maximizeschneider/Clawdmeter/enclosure/retro_tv/preview_right.png

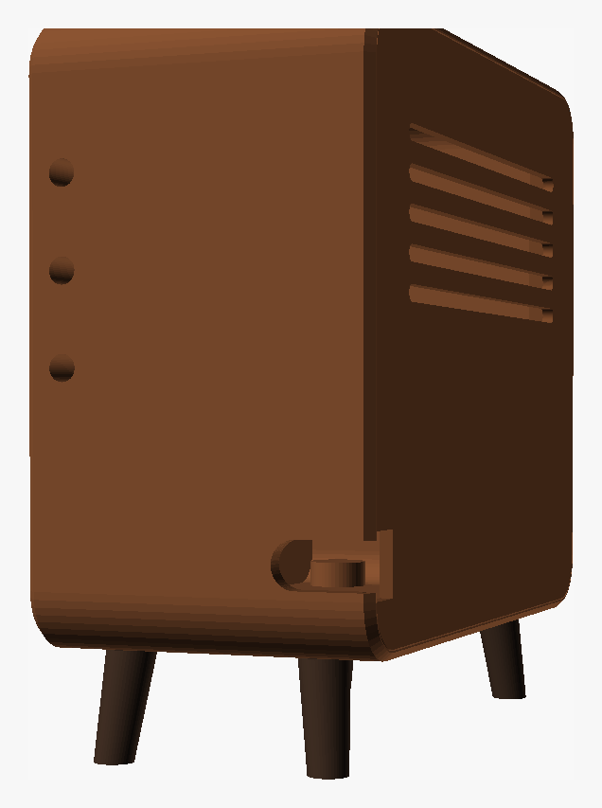
enclosure/retro_tv/preview_right.png
