maximizeschneider/Clawdmeter/enclosure/retro_tv/stl/0_fit_test.stl

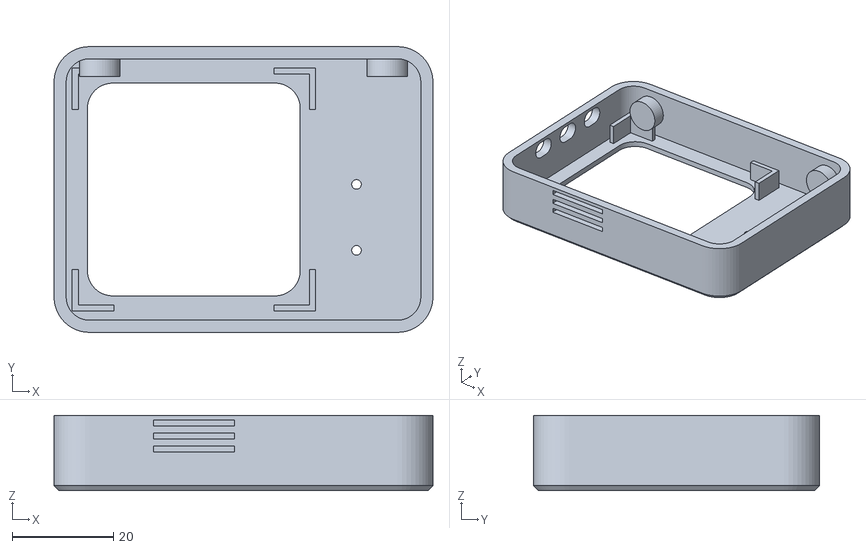
[picture p6: CAD file, 2026-10-17]
enclosure/retro_tv/stl/0_fit_test.stl
74.8 x 56.4 x 14.9
