maximizeschneider/Clawdmeter/enclosure/retro_tv/stl/1_classic/4_grey.stl

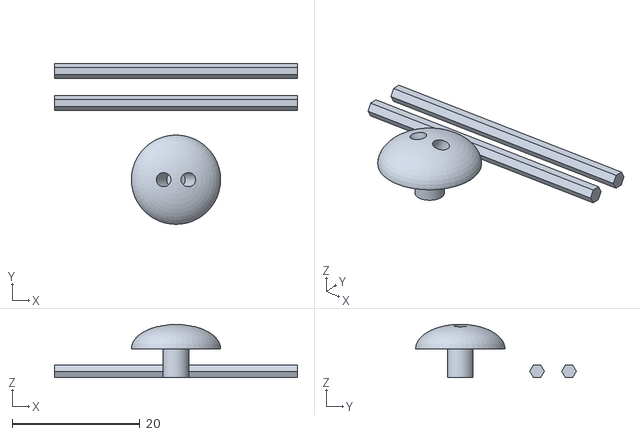
[picture p7: CAD file, 2026-10-17]
enclosure/retro_tv/stl/1_classic/4_grey.stl
38.0 x 25.1 x 8.34
