maximizeschneider/Clawdmeter/enclosure/retro_tv/stl/2_black_grey/2_light_grey.stl

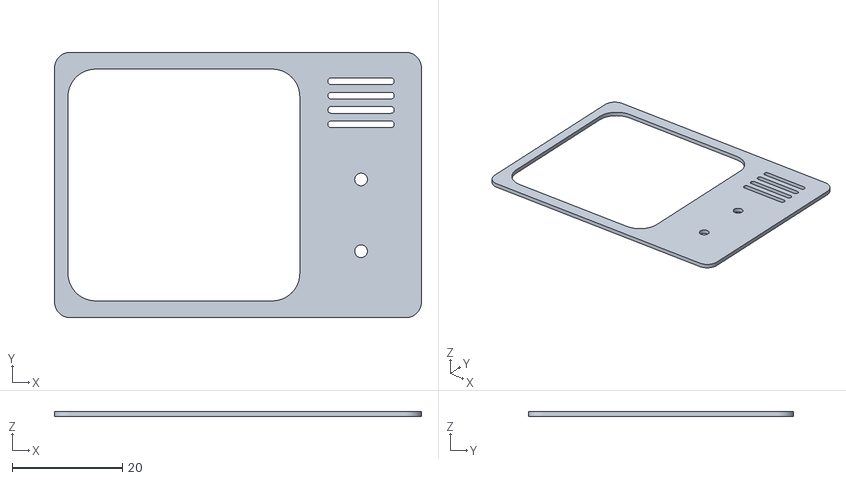
[picture p8: CAD file, 2026-10-17]
enclosure/retro_tv/stl/2_black_grey/2_light_grey.stl
66.5 x 48.1 x 0.95
