maximizeschneider/Clawdmeter/enclosure/retro_tv/stl/4_white_black/2_black.stl

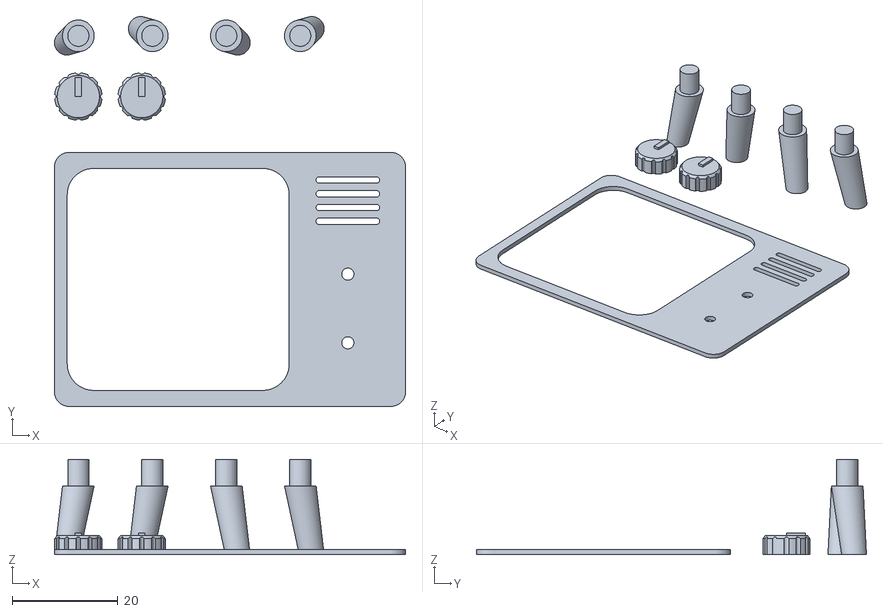
[picture p9: CAD file, 2026-10-17]
enclosure/retro_tv/stl/4_white_black/2_black.stl
66.5 x 73.8 x 18.0
