maximizeschneider/Clawdmeter/enclosure/retro_tv/stl/6_one_colour/any_single_colour.stl

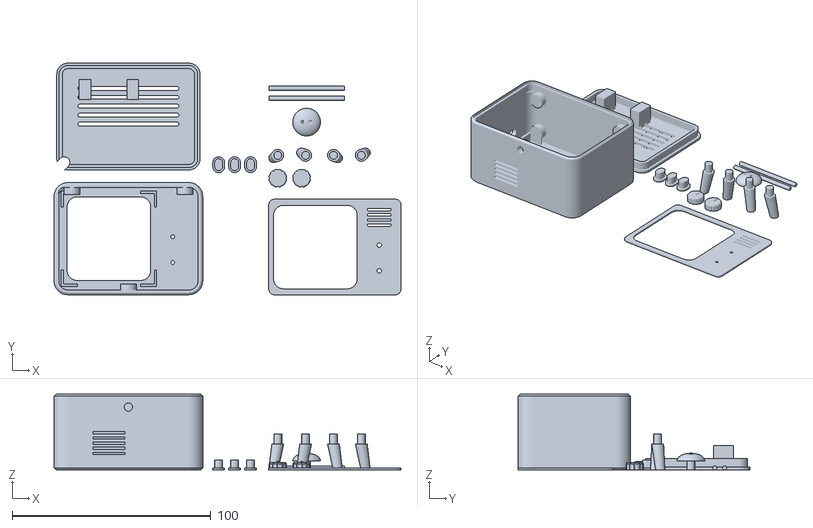
[picture p10: CAD file, 2026-10-17]
enclosure/retro_tv/stl/6_one_colour/any_single_colour.stl
174.4 x 116.5 x 38.0
