maximizeschneider/Clawdmeter/enclosure/retro_tv/stl/1_classic/1_walnut_brown.stl

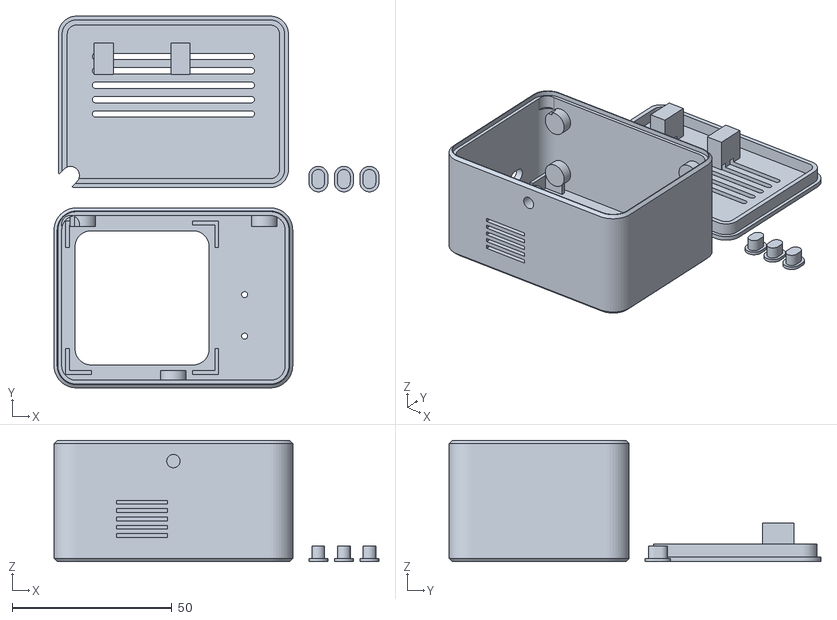
[picture p11: CAD file, 2026-10-17]
enclosure/retro_tv/stl/1_classic/1_walnut_brown.stl
101.8 x 116.4 x 38.0
