maximizeschneider/Clawdmeter/enclosure/retro_tv/stl/2_black_grey/1_black.stl

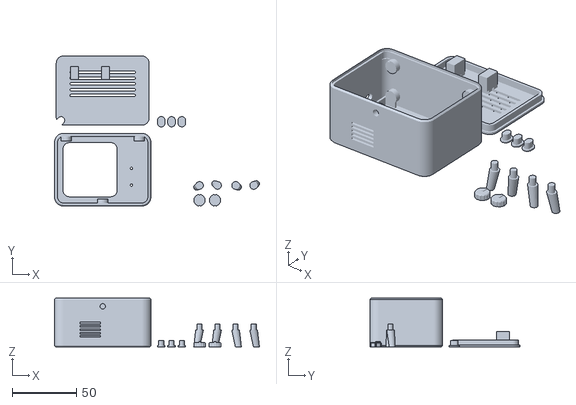
[picture p12: CAD file, 2026-10-17]
enclosure/retro_tv/stl/2_black_grey/1_black.stl
159.0 x 116.4 x 38.0
