maximizeschneider/Clawdmeter/enclosure/retro_tv/stl/3_dark.stl

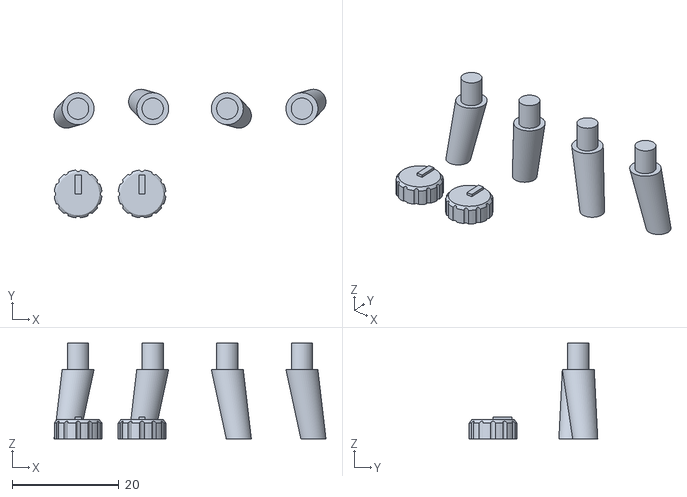
[picture p13: CAD file, 2026-10-17]
enclosure/retro_tv/stl/3_dark.stl
51.0 x 24.1 x 18.0
