maximizeschneider/Clawdmeter/enclosure/retro_tv/stl/5_white_grey/3_grey.stl

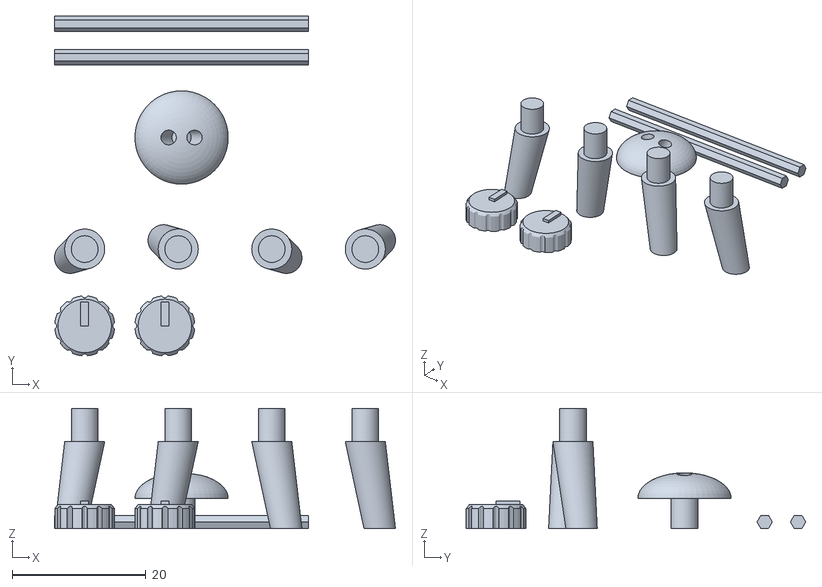
[picture p14: CAD file, 2026-10-17]
enclosure/retro_tv/stl/5_white_grey/3_grey.stl
51.0 x 50.8 x 18.0
