maximizeschneider/Clawdmeter/enclosure/retro_tv/stl/parts/body.stl

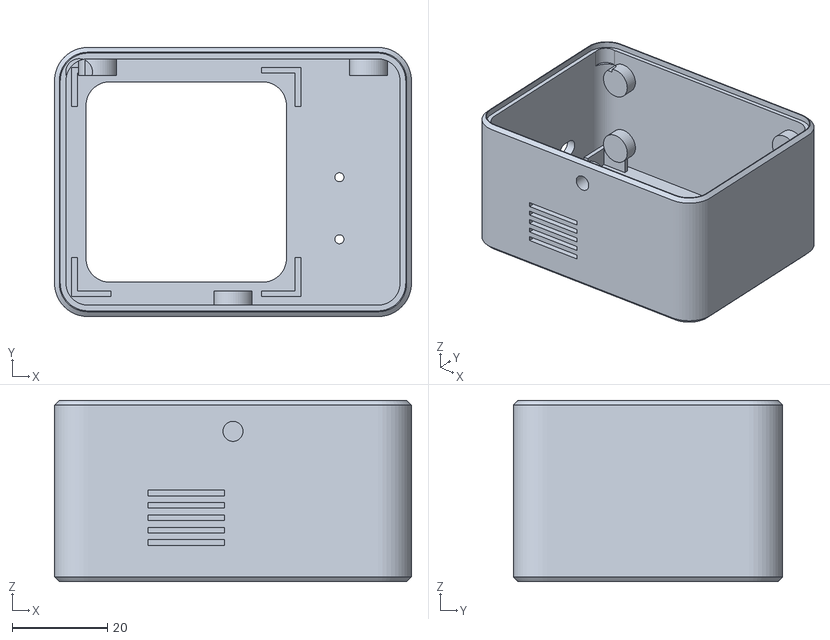
[picture p15: CAD file, 2026-10-17]
enclosure/retro_tv/stl/parts/body.stl
74.8 x 56.4 x 38.0
