maximizeschneider/Clawdmeter/enclosure/retro_tv/stl/parts/back_cover.stl

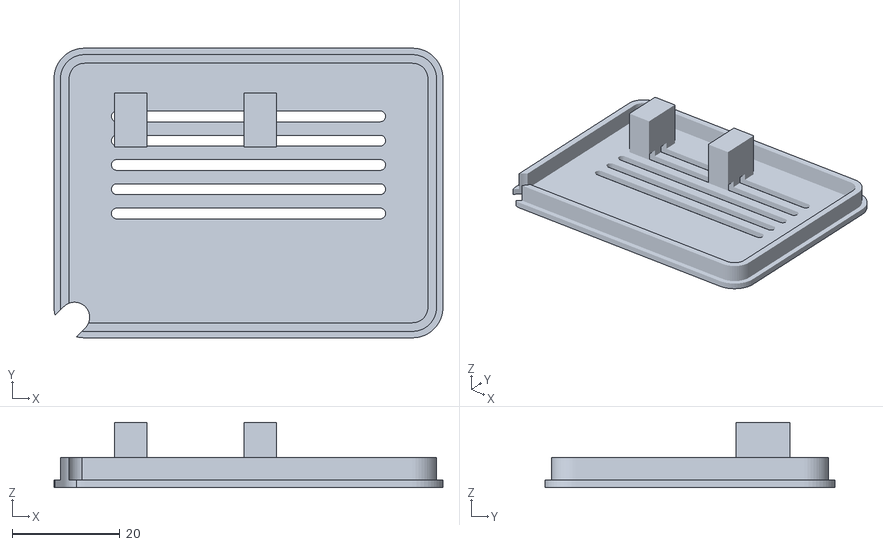
[picture p16: CAD file, 2026-10-17]
enclosure/retro_tv/stl/parts/back_cover.stl
72.1 x 53.7 x 12.1
