maximizeschneider/Clawdmeter/enclosure/retro_tv/stl/1_classic/3_dark_brown.stl

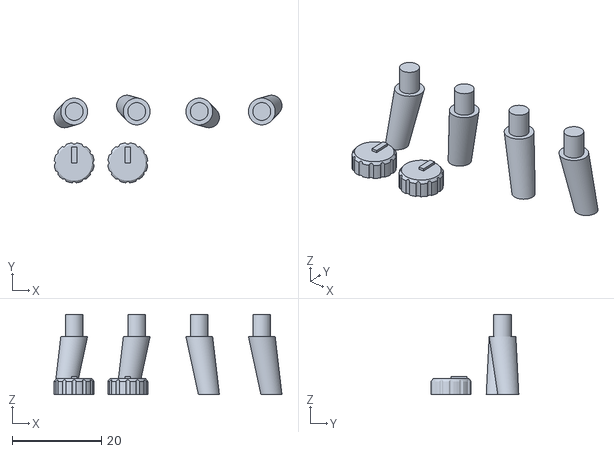
[picture p17: CAD file, 2026-10-17]
enclosure/retro_tv/stl/1_classic/3_dark_brown.stl
51.0 x 19.6 x 18.0
