maximizeschneider/Clawdmeter/enclosure/retro_tv/stl/2_cream.stl

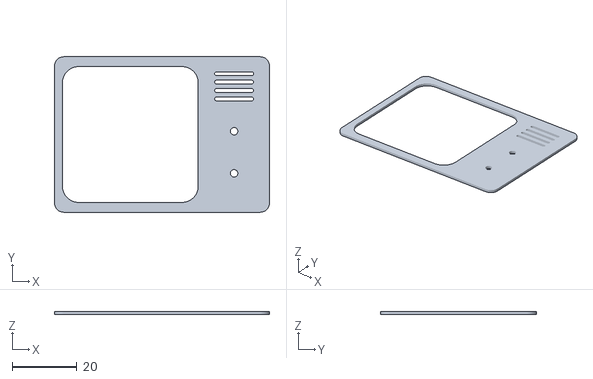
[picture p18: CAD file, 2026-10-17]
enclosure/retro_tv/stl/2_cream.stl
66.5 x 48.1 x 0.95
