maximizeschneider/Clawdmeter/enclosure/retro_tv/stl/parts/knobs.stl

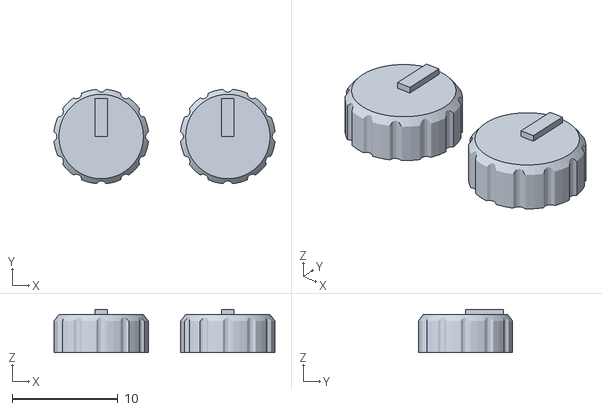
[picture p19: CAD file, 2026-10-17]
enclosure/retro_tv/stl/parts/knobs.stl
20.9 x 8.94 x 4.10
