maximizeschneider/Clawdmeter/enclosure/retro_tv/stl/parts/plungers.stl

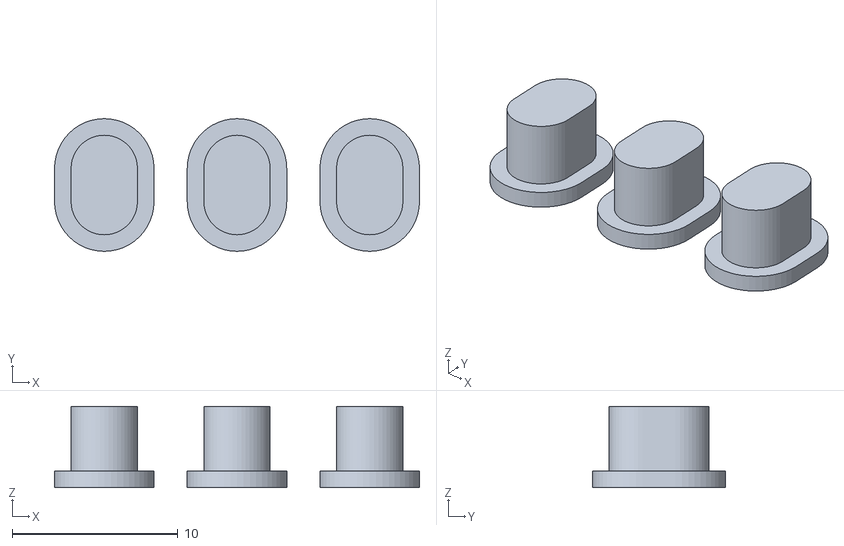
[picture p20: CAD file, 2026-10-17]
enclosure/retro_tv/stl/parts/plungers.stl
22.0 x 8.00 x 4.90
