maximizeschneider/Clawdmeter/enclosure/retro_tv/stl/parts/legs.stl

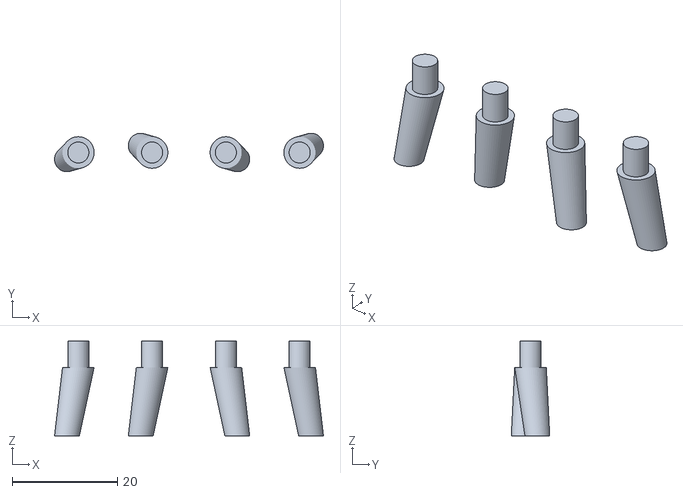
[picture p21: CAD file, 2026-10-17]
enclosure/retro_tv/stl/parts/legs.stl
51.0 x 7.30 x 18.0
