maximizeschneider/Clawdmeter/(list of files, cad)

Other CAD files:
enclosure/retro_tv/stl/3_grey_white/2_white.stl
enclosure/retro_tv/stl/5_white_grey/2_light_grey.stl
enclosure/retro_tv/stl/parts/antenna.stl
enclosure/retro_tv/stl/3_grey_white/1_grey.stl
enclosure/retro_tv/stl/4_white_black/1_white.stl
enclosure/retro_tv/stl/1_brown.stl
enclosure/retro_tv/stl/1_classic/2_cream.stl
enclosure/retro_tv/stl/2_black_grey/3_grey.stl
enclosure/retro_tv/stl/3_grey_white/3_black.stl
enclosure/retro_tv/stl/4_white_black/3_grey.stl
enclosure/retro_tv/stl/5_white_grey/1_white.stl
enclosure/retro_tv/stl/4_grey.stl
enclosure/retro_tv/stl/fit_test.stl
enclosure/retro_tv/stl/parts/faceplate.stl
enclosure/retro_tv/stl/antenna.stl
enclosure/retro_tv/stl/back_cover.stl
enclosure/retro_tv/stl/body.stl
enclosure/retro_tv/stl/faceplate.stl
enclosure/retro_tv/stl/knobs.stl
enclosure/retro_tv/stl/legs.stl
enclosure/retro_tv/stl/plungers.stl
