maximizeschneider/Clawdmeter/(commit log)

2026-10-01 Add Fable weekly bar and monthly tokens/cost to the usage screen
    The macOS daemon now adds two optional extras to the BLE payload:
    - m/mr/ml: a per-model weekly limit (Fable by default) from the OAuth
    usage endpoint behind Claude Code's /usage screen. The last good value
    is reused for up to 10 minutes so a single failed fetch doesn't blink
    the bar off.
    - mt/mc: this calendar month's tokens and API-list-price cost, summed
    from local Claude Code transcripts (de-duplicated per message, only
    changed files re-parsed each poll).
    Both are configurable (model_limit, monthly) and best-effort. Firmware
    shows them as a third bar plus a "This month" line, using a denser panel
    geometry for al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
    [data.h, main.cpp, ui.cpp]
2026-10-01 Make token prices configurable via the daemon config
    `price.<model> = input, output, cache_read` lines override or extend the
    built-in price table and take effect on the next poll, no restart. Token
    counts are now cached per message and priced on every roll-up, so a price
    change re-prices the current month immediately. Price lookup uses the
    longest matching key, so table order no longer matters.
    Claude-Session: https://claude.ai/code/session_01C7kxVnBMKmtFow8jNyEp63
2026-10-14 Add model_label config for the per-model limit bar
    The usage endpoint exposes some limits under internal bucket names
    (e.g. iguana_necktie), which made the derived pill label unreadable.
    `model_label = Fable` sets the bar's label explicitly.
    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
2026-10-14 Report the installed Claude Code version to the usage endpoint
    /api/oauth/usage only returns per-model weekly buckets (seven_day_opus,
    seven_day_sonnet, ...) to recent Claude Code versions; with the old
    hard-coded claude-code/2.1.5 they're missing entirely. The usage fetch
    now sends claude-code/<installed version>, read from `claude --version`
    (re-checked hourly, with known install paths for launchd's minimal PATH)
    and falling back to a recent version when the CLI isn't found.
    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
2026-10-14 Find the Fable weekly limit in the usage endpoint's limits list
    The Fable limit isn't a top-level seven_day_* key: /api/oauth/usage
    reports it as a "weekly_scoped" entry in "limits" whose scope.model
    display name is "Fable" (verified against a real response: 31%, resets
    with the weekly window). pick_model_limit now checks that list, so the
    default `model_limit = fable` works, and the no-match log lists the
    scoped model names instead of every internal bucket key.
    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
2026-10-17 Add parametric OpenSCAD retro-PC dock for the C6 AMOLED-2.16
    Tilted Mac-style enclosure with hidden right-angle USB-C, side-button
    plungers, snap clips, friction-fit back cover and a quick fit-test part.
    Board dimensions are placeholders to be measured.
    Claude-Session: https://claude.ai/code/session_01DCgFXNHjuUnVVy5jf825vG
2026-10-17 Replace retro-PC enclosure with a retro-TV dock
    Two-tone TV body (walnut body + cream faceplate) with control-panel knobs,
    speaker grille, splayed legs that set a 12 degree lean-back, and rabbit-ear
    antennas. The right-angle USB-C cable runs right inside the case and exits
    through a notch low on the right side. Side-button plungers, clip posts for
    the board, and a fit-test slice. Board dimensions are still placeholders.
    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
2026-10-17 Retro-TV dock: stand upright, more room for the L-plug
    Tilt 0 (all legs equal). plug_room 14 -> 18 mm so an ordinary L-shaped
    USB-C plug fits under the board with its cable heading back. README now
    states the real outer size and adds a dims part that echoes it.
    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
2026-10-17 Retro-TV dock: mount the board sideways (USB-C right, buttons left)
    The right-angle plug now hides behind the control panel instead of under
    the screen, so the case drops the 18 mm chin and becomes slightly wider
    than tall (75 x 69 x 42 mm). Buttons are pressed through the left wall,
    clip posts move to the board's top and bottom edges, and the cable exits
    from the plug's height on the right side. Buttons are now specified in
    mounted coordinates.
    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
2026-10-17 Retro-TV dock: cable exits through the back cover
    The cable now runs straight back from the plug and leaves through a hole
    near the right edge of the back cover, at plug height. In the cover it is a
    notch open to the edge, so the cover still goes on over a plugged-in cable.
    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
2026-10-17 Retro-TV dock: cable exits at the bottom-right corner of the back
    The cable now droops from the plug in a gentle curve to a hole on the
    diagonal of the back cover's bottom-right corner, instead of a tight bend
    at plug height. The cover keeps a notch open to the corner so it still
    goes on over a plugged-in cable.
    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
2026-10-17 Retro-TV dock: move cable exit to the button-side bottom corner
    Seen from behind this is the bottom-right corner. The cable runs from the
    plug down and along the floor behind the board to the hole.
    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
2026-10-17 Retro-TV dock: fit the finished device shell (45 x 45 x 22 mm)
    The C6 AMOLED-2.16 comes in its own white shell, so the TV now holds that
    cube instead of a bare PCB: corner brackets centre it, two pressers on the
    back cover hold it against the front lip, the window (42 mm) stays inside
    the 43 mm glass so the white rim never shows, button holes match the
    measured 12.5/22.5/32.5 mm positions, and slots in the top sit over the
    device's speaker. The body shrinks to 75 x 56 x 35 mm.
    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
2026-10-17 Retro-TV dock: measured button depth (9.5 mm behind the shell rim)
    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
2026-10-17 Retro-TV dock: 16 mm cable lane behind the device for a stiff cable
    Braided USB-C cable cannot fold flat against the device's back; the lane
    now leaves ~12 mm bend radius for the turn from the plug round the back
    and the turn out of the exit hole. The back-cover pressers move up to the
    top of the device so the cable passes underneath them. Body depth is now
    42 mm.
    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
2026-10-17 Retro-TV dock: 38 mm deep, cable lane sized from the real cable
    Photos of the braided cable bent round the device show its loop sticks
    out ~7-9 mm behind the device's back, so the lane drops from 16 to 12 mm
    (body depth 42 -> 38 mm). The speaker grille turned out to be on the
    device's back, so its sound leaves through the back-cover vents; the top
    slots are now documented as decorative.
    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
2026-10-17 Retro-TV dock: speaker grille faces up, top slots are functional
    Correct the previous commit: the device's speaker grille is on the side
    that faces up when mounted (the back is only a sticker), so the slots in
    the TV's top are the speaker's outlet, not decoration.
    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
2026-10-17 Retro-TV dock: ready-to-print STLs and a printing guide
    Exported every part in print orientation to enclosure/retro_tv/stl/ and
    added PRINTING.md with slicer settings, colours, print order (fit test
    first) and rough times, for someone printing it without OpenSCAD.
    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
2026-10-17 Retro-TV dock: button pins match the device's pill-shaped buttons
    The round 2.8 mm pins become 6 x 4 mm pills, the size of the device's own
    buttons, in matching pill holes in the left wall (0.4 mm clearance), with
    a wider pill head inside that keeps them from falling out.
    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
2026-10-17 Retro-TV dock: one print plate per filament colour
    Add plate_brown/cream/dark/grey parts and export them as numbered STLs
    (0_fit_test, 1_brown ... 4_grey) so the printer loads one file per colour;
    single parts move to stl/parts/. The button pins are now body-coloured
    (on the brown plate) so they blend into the TV's side.
    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
2026-10-17 Retro-TV dock: preview colours as parameters
    col_body / col_face / col_dark / col_ant set the assembly preview colours
    so colour schemes can be tried with -D or the Customizer.
    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
2026-10-17 Retro-TV dock: print plates for six colour schemes
    Replace the fixed brown/cream/dark/grey plates with a plate() builder that
    takes the part groups sharing one filament, and export a folder per colour
    scheme (classic, black/grey, grey/white, white/black, white/grey, one
    colour), one STL per filament. Every plate fits a 180 x 180 mm bed.
    PRINTING.md explains the folders and shows the schemes.
    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
